BlokasLabs/pisound-micro-docs/docs/images/Pisound_Micro.png

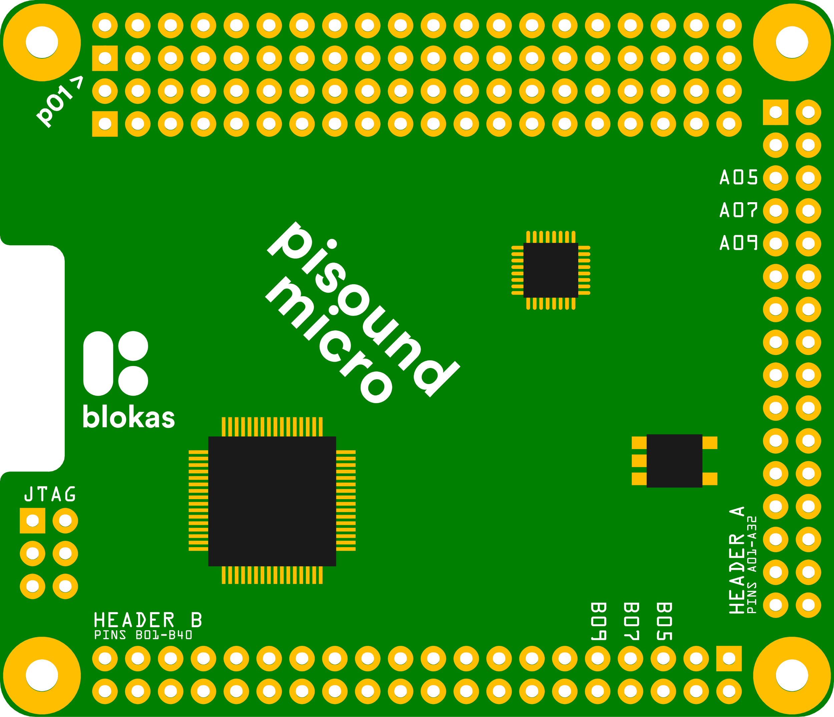
docs/images/Pisound_Micro.png
