BlokasLabs/pisound-micro-docs/media/Pisound Micro.png

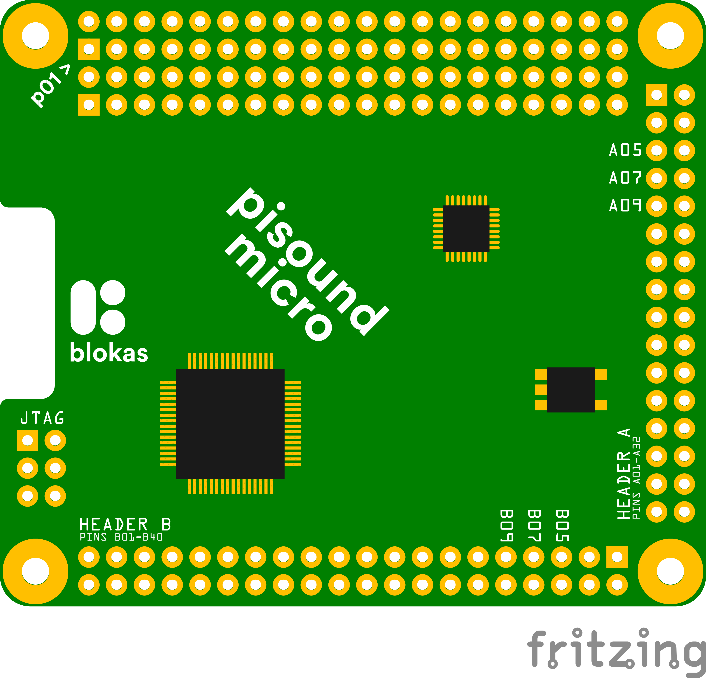
media/Pisound Micro.png
