BlokasLabs/pisound-micro-docs/docs/images/Pisound_Micro_Mechanical_Drawing.pdf

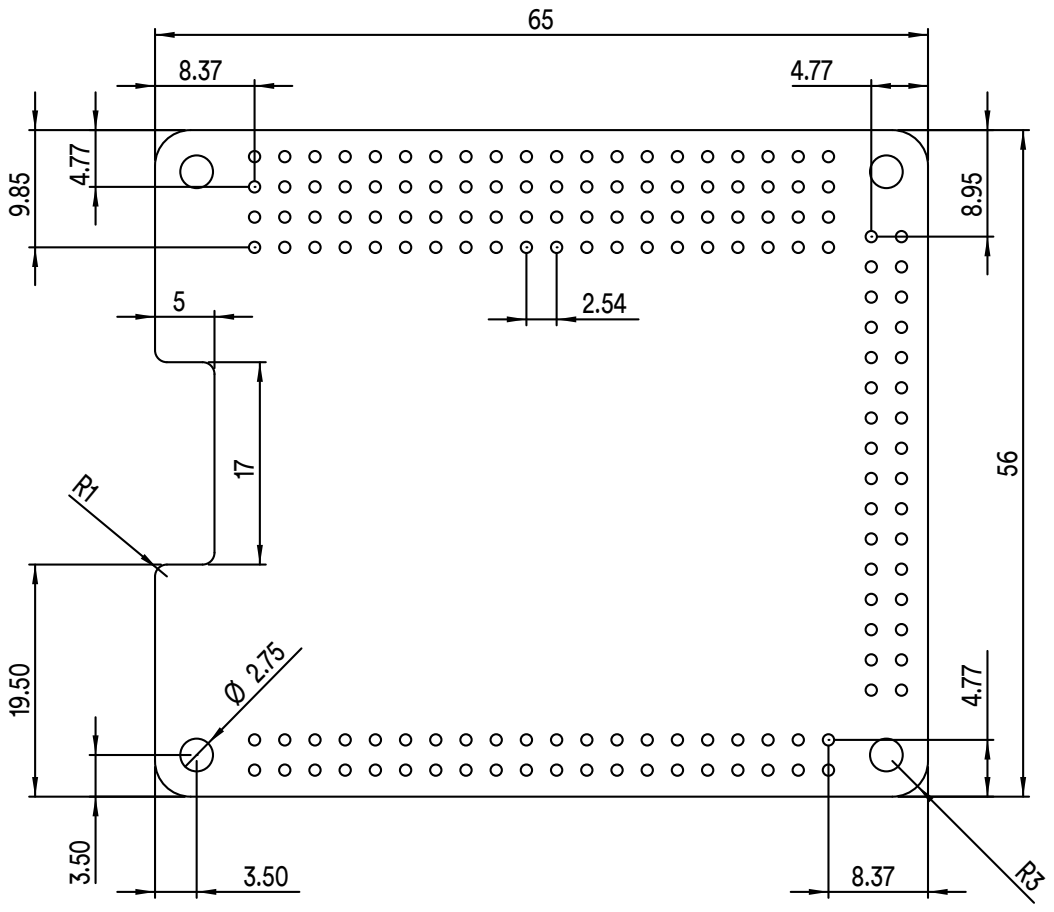
[picture p35: page 1]
