BlokasLabs/pisound-micro-docs/(list of files, drawings)

Other design files:
media/Audio_Connections.fzz
media/Capless_HP.fzz
media/Direct_Wire_RPi.fzz
media/GPIO_Activity_LED.fzz
media/GPIO_Encoder.fzz
media/GPIO_LED.fzz
media/GPIO_Potentiometer.fzz
media/GPIO_Switch.fzz
media/HP_Electrolytic_Caps.fzz
media/HP_Line_Out.fzz
media/Line_Diffferential_Input.fzz
media/Line_Diffferential_Output.fzz
media/Line_MicBias_Electret_Input.fzz
media/Line_Single_Ended_Input.fzz
media/Line_Single_Ended_Output.fzz
media/MIDI_Connections.fzz
media/Virtual Ribbon.fzz
