BlokasLabs/pisound-micro-docs/(commit log)

2023-09-15 Hardware setup guide and connection illustrations
    [Audio_Connections.fzz, Direct_Wire_RPi.fzz, MIDI_Connections.fzz, Virtual Ribbon.fzz]
2023-09-18 Added schematic images to documentation
    [GPIO_Activity_LED.fzz, GPIO_Encoder.fzz, GPIO_LED.fzz, GPIO_Potentiometer.fzz, GPIO_Switch.fzz, MIDI_Connections.fzz]
2024-11-22 Updated images
    [Audio_Connections.fzz, GPIO_Activity_LED.fzz, MIDI_Connections.fzz]
2025-03-28 Added media files
    [HP_Electrolytic_Caps.fzz]
2025-04-16 Audio connection illustrations
    [Capless_HP.fzz, HP_Line_Out.fzz, Line_Diffferential_Input.fzz, Line_Diffferential_Output.fzz, Line_MicBias_Electret_Input.fzz, Line_Single_Ended_Input.fzz, Line_Single_Ended_Output.fzz]
